HappyHappyCMD/PROSTHETIC-HAND/prosthetichand.3mf

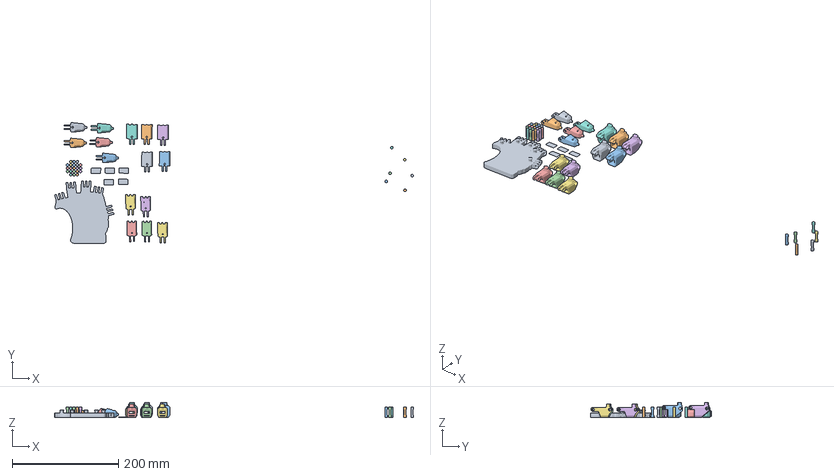
[picture p3: CAD file, 2026-10-21]
prosthetichand.3mf
676.4 x 227.8 x 28.8 mm
prothese 1.stl_B_B_B_B_B
prothese 12.stl x 27
prothese 1.3.stl x 5
prothese 2.1.stl x 5
prothese 2.2.stl x 5
