HappyHappyCMD/PROSTHETIC-HAND/prosthetichand.kicad_sch

## KiCad design prosthetichand.kicad_sch (2026-10-21)

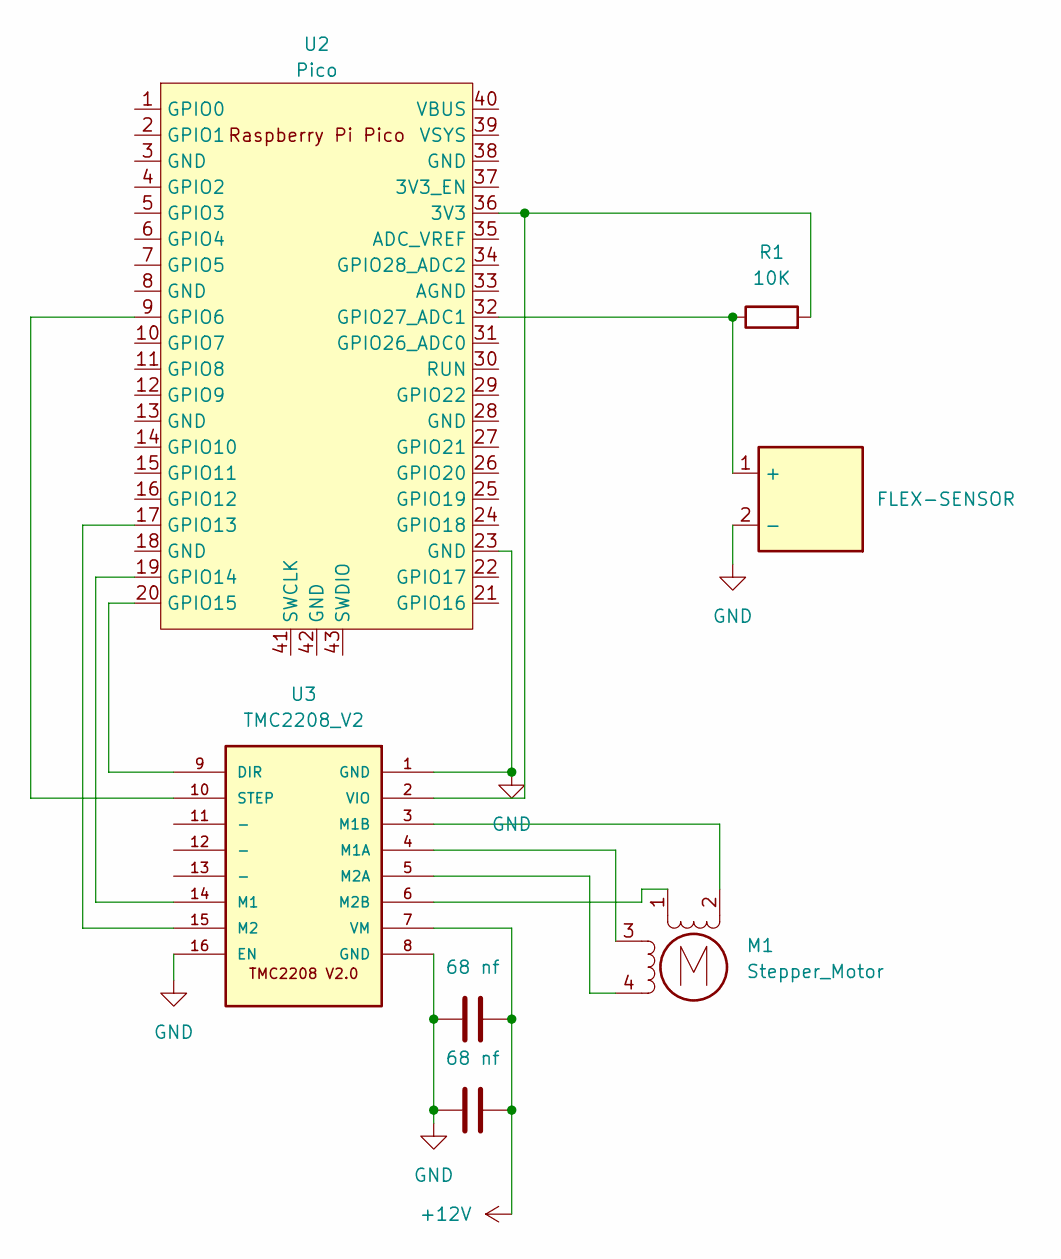
[picture p4: schematic prosthetichand.kicad_sch]

Parts:
C1, C2: 68 nf
FLEX-SENSOR: SOT-23-5
M1: Stepper_Motor
R1: 10K
U2: Pico; RPi_Pico_SMD_TH
U3: TMC2208_V2

Connections:
+12V: C1.2, C2.2, U3.7 (VM)
GND: C1.1, C2.1, FLEX-SENSOR.2 (NC), U2.23 (GND), U3.1 (GND), U3.8 (GND), U3.16 (EN)
unnamed: FLEX-SENSOR.1 (+), R1.1, U2.32 (GPIO27_ADC1)
unnamed: M1.1, U3.6 (M2B)
unnamed: M1.2 (-), U3.3 (M1B)
unnamed: M1.3, U3.4 (M1A)
unnamed: M1.4, U3.5 (M2A)
unnamed: R1.2, U2.36 (3V3), U3.2 (VIO)
unnamed: U2.9 (GPIO6), U3.10 (STEP)
unnamed: U2.17 (GPIO13), U3.15 (M2)
unnamed: U2.19 (GPIO14), U3.14 (M1)
unnamed: U2.20 (GPIO15), U3.9 (DIR)
