HappyHappyCMD/PROSTHETIC-HAND/(commit log)

2026-09-15 Gammal motor+LCD-kod
    För att bygga upp motorstyrningsprogram
2026-09-15 Create Motorkod
    Gammal motorkod
2026-09-24 Add motor control logic with ADC for speed adjustment
2026-10-19 Add new file Motorkod_flex.c
2026-10-21 print fil
    [prosthetichand.3mf]
